chickadee-tech/uOSD/pcb/Bill_Of_Materials.csv

part name | symbol | size (imp) | max current | unit price | units per build | units in stock | order total | Manufacturer ID | source url | datasheet | datasheet2
80 pin header | PORT_IN1 |  |  | $1.35 | 1 | 1 | $1.35 | DF40C-80DP-0.4V(51) | http://www.digikey.com/product-detail/en/DF40C-80DP-0.4V(51)/H11632CT-ND/1969511 | N | http://www.hirose.co.jp/cataloge_hp/ed_DF40_20140305.pdf |  | Total Base Cost | $8.49
80 pin receptacle (4.0mm) | PORT_OUT1 |  |  | $2.67 | 1 | 8 | $2.67 | DF40HC(4.0)-80DS-0.4V(51) | http://www.digikey.com/product-detail/en/DF40HC(4.0)-80DS-0.4V(51)/H11919CT-ND/2530301 | N |  | price ranges 1.40 - 2.50
AND/OR gate | PORT_ANDOR1 |  |  | $0.25 | 1 | 2 | $0.25 | SN74LVC1G0832DCKR | http://www.digikey.com/product-detail/en/SN74LVC1G0832DCKR/296-18754-1-ND/863884 |  | http://www.ti.com/lit/ds/symlink/sn74lvc1g0832.pdf
multifunction gate | PORT_XOR1, PORT_INV1 |  |  | $0.14 | 2 | 6 | $0.28 | SN74LVC1G58DCKR | http://www.digikey.com/product-detail/en/SN74LVC1G58DCKR/296-15577-1-ND/571153 |  | http://www.ti.com/lit/ds/symlink/sn74lvc1g58.pdf
64kbit eeprom | PORT_IC1 | udfn |  | $0.61 | 1 | 2 | $0.61 | AT24CS64-MAHM-T | http://www.digikey.com/product-detail/en/AT24CS64-MAHM-T/AT24CS64-MAHM-TCT-ND/4292118 | N | http://www.atmel.com/images/atmel-8870-seeprom-at24cs64-datasheet.pdf
R 10k | PORT_R1 | 603 |  | $0.01 | 1 | 979 | $0.01 | RC0603FR-0710KL | http://www.digikey.com/product-detail/en/RC0603FR-0710KL/311-10.0KHRCT-ND/729827 | MF-RES-0603-10K | http://www.yageo.com/NewPortal/yageodocoutput?fileName=/pdf/R-Chip/PYu-RC_Group_51_RoHS_L_3.pdf
C 0.1uF | PORT_C1 | 603 |  | $0.02 | 1 | 400 | $0.02 | C0603C104K4RACTU | http://www.digikey.com/product-detail/en/C0603C104K4RACTU/399-1096-1-ND/411371 | MF-CAP-0603-0.1uF | http://www.kemet.com/docfinder?Partnumber=C0603C104K4RACTU
C 10uF X5R | C1 | 1206 |  | $0.24 | 1 | 80 | $0.24 | C3216X5R1C106M160AA | http://www.digikey.com/product-detail/en/C3216X5R1C106M160AA/445-1426-1-ND/569092 | MF-CAP-1206-10uF | http://product.tdk.com/en/catalog/datasheets/mlcc_commercial_general_en.pdf
C 0.1uF | C2, C3 | 603 |  | $0.02 | 2 | 400 | $0.04 | C0603C104K4RACTU | http://www.digikey.com/product-detail/en/C0603C104K4RACTU/399-1096-1-ND/411371 | MF-CAP-0603-0.1uF | http://www.kemet.com/docfinder?Partnumber=C0603C104K4RACTU
red led | D1 |  |  | $0.19 | 1 | 71 | $0.19 | LTST-C190KRKT | http://www.digikey.com/product-detail/en/LTST-C190KRKT/160-1436-1-ND/386816 | MF-LED-0603-RED | http://optoelectronics.liteon.com/upload/download/DS-22-99-0151/S_110_LTST-C190KRKT.pdf
Schottky Diode (Logic Level) | D2 | SC-79, SOD-523F | 30mA | $0.19 | 1 | 4 | $0.19 | RB751S40 | http://www.digikey.com/product-detail/en/RB751S40/RB751S40CT-ND/1969050 | N | https://www.fairchildsemi.com/datasheets/RB/RB751S40.pdf
1x6 right angle tin | Off Board |  |  | $0.33 | 1 | 0 | $0.33 | 22-28-8060 |  | N
1x6 straight | Off Board |  |  | $0.30 | 1 | 3 | $0.30 | 22-28-4060 |  | N
R 1k | R1 | 603 |  | $0.01 | 1 | 993 | $0.01 | RC0603FR-071KL | http://www.digikey.com/product-detail/en/RC0603FR-071KL/311-1.00KHRCT-ND/729790 | MF-RES-0603-1K | http://www.yageo.com/NewPortal/yageodocoutput?fileName=/pdf/R-Chip/PYu-RC_Group_51_RoHS_L_3.pdf
R 10k | R2, R3, R4 | 603 |  | $0.01 | 3 | 979 | $0.03 | RC0603FR-0710KL | http://www.digikey.com/product-detail/en/RC0603FR-0710KL/311-10.0KHRCT-ND/729827 | MF-RES-0603-10K | http://www.yageo.com/NewPortal/yageodocoutput?fileName=/pdf/R-Chip/PYu-RC_Group_51_RoHS_L_3.pdf
R 470 | R5 | 603 |  | $0.00 | 1 | 498 | $0.00 | RC0603JR-07470RL | http://www.digikey.com/product-detail/en/yageo/RC0603JR-07470RL/311-470GRCT-ND/729738 | MF-RES-0603-470 | http://www.yageo.com/NewPortal/yageodocoutput?fileName=/pdf/R-Chip/PYu-RC_Group_51_RoHS_L_3.pdf
Auto Power Switch | U1 | 8-TSSOP | 900mA | $1.84 | 1 | 1 | $1.84 | TPS2112APWR | http://www.ti.com/lit/ds/symlink/tps2112a.pdf | N | http://www.ti.com/lit/ds/symlink/tps2112a.pdf
4mm Spacer | Off Board |  |  | $0.04 | 1 | 78 | $0.04 | 908-4MM | http://www.mouser.com/ProductDetail/Bivar/908-4MM/ | N | http://www.bivar.com/Portals/0/Products/d.ashx?f=/Portals/0/products/9XX-XXX.pdf
n-channel mosfet | Q1 | TO-236-3, SC-59, SOT-23-3 | 220mA continuous | $0.09 | 1 | 59 | $0.09 | BSS138 | http://www.digikey.com/product-detail/en/BSS138/BSS138CT-ND/244294 | MF-DSC-SOT233-BSS138 | https://www.fairchildsemi.com/datasheets/BS/BSS138.pdf
