chickadee-tech/uOSD/pcb/uMinimOSD.kicad_pcb

## KiCad design pcb/uMinimOSD.kicad_pcb (2016-07-07)

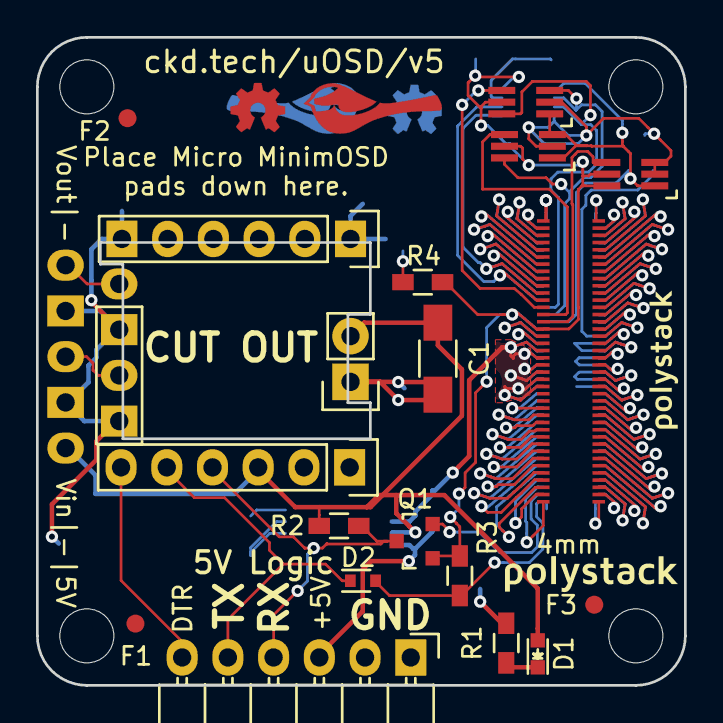
[picture p1: board uMinimOSD.kicad_pcb from above]

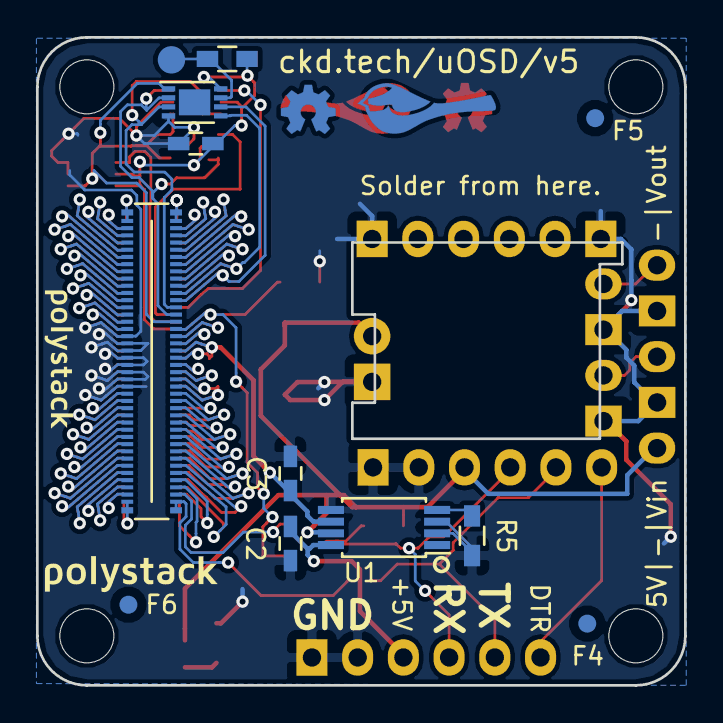
[picture p2: board uMinimOSD.kicad_pcb from below]

Board: 2 copper layers, 36.0 x 36.0 mm, 37 parts (14 on the bottom side), 81 nets.

Parts:
C1: 10uF; C_1206_HandSoldering
C2, C3: 0.1uF; C_0603_HandSoldering
D1: Red; LED-0603
D2: RB751S40; SOD-523
F1, F2, F3, F4, F5, F6: 1mm; Fiducial
P1: CONN_01X05; Pin_Header_Straight_1x05
P2: CONN_01X04; Pin_Header_Straight_1x04
P3, P4: CONN_01X06; Pin_Header_Straight_1x06
P5: CONN_01X02; Pin_Header_Straight_1x02
P6: CONN_01X06; Pin_Header_Angled_1x06
PORT_ANDOR1: SN74LVC1G0832; SC-70-6_Handsoldering
PORT_C1: 0.1uF; C_0603_HandSoldering
PORT_IC1: AT24CS02-MAHM; DFN-8-1EP_3x2mm_Pitch0.5mm
PORT_IN1: CKD_SANDWICH; DF40-80pin-Header
PORT_INV1: SN74LVC1G58; SC-70-6_Handsoldering
PORT_OUT1: CKD_SANDWICH; DF40-3-4mm-80pin-Receptacle
PORT_P1: CONN_01X01; Measurement_Point_Round-SMD-Pad_Small
PORT_R1: 10k; R_0603_HandSoldering
PORT_XOR1: SN74LVC1G58; SC-70-6_Handsoldering
Q1: Q_NMOS_GSD; SOT-23
R1: 1k; R_0603_HandSoldering
R2, R3, R4: 10k; R_0603_HandSoldering
R5: 470; R_0603_HandSoldering
U1: TPS2112; TSSOP-8_4.4x3mm_Pitch0.65mm
svg2mod, svg2mod#2: G***; polystack-bold-0.5
svg2mod#3, svg2mod#4: G***; polystack-bold-0.4

Connections:
+3V3: PORT_ANDOR1.5, PORT_C1.1, PORT_IC1.8, PORT_IN1.16, PORT_INV1.5, PORT_INV1.6, PORT_OUT1.16, PORT_R1.2, PORT_XOR1.5, Q1.1, R3.1, R4.1
+5V: C1.1, D1.2, P1.1, P3.3, P5.2, R2.1, U1.7
/DTR: P3.6, P6.6
/ExpansionPort/3V3_0.3A_E: PORT_IN1.17, PORT_OUT1.17
/ExpansionPort/+BATT: PORT_IN1.18, PORT_OUT1.18
/ExpansionPort/ADC1: PORT_IN1.49, PORT_OUT1.49
/ExpansionPort/ADC2: PORT_IN1.50, PORT_OUT1.50
/ExpansionPort/BOOT: PORT_IN1.65, PORT_OUT1.65
/ExpansionPort/CAN_HI: PORT_IN1.67, PORT_OUT1.67
/ExpansionPort/CAN_LO: PORT_IN1.68, PORT_OUT1.68
/ExpansionPort/FS_5V: C3.1, PORT_IN1.19, PORT_IN1.20, PORT_IN1.21, PORT_IN1.22, PORT_IN1.23, PORT_IN1.24, PORT_OUT1.19, PORT_OUT1.20, PORT_OUT1.21, PORT_OUT1.22, PORT_OUT1.23, PORT_OUT1.24, U1.6
/ExpansionPort/GPIO1: PORT_IN1.5, PORT_OUT1.5
/ExpansionPort/GPIO2: PORT_IN1.6, PORT_OUT1.6
/ExpansionPort/GPIO3: PORT_IN1.7, PORT_OUT1.7
/ExpansionPort/GPIO4: PORT_IN1.8, PORT_OUT1.8
/ExpansionPort/GPIO5: PORT_IN1.9, PORT_OUT1.9
/ExpansionPort/GPIO6: PORT_IN1.10, PORT_OUT1.10
/ExpansionPort/HEIGHT_1: PORT_ANDOR1.1, PORT_IC1.1, PORT_IN1.15, PORT_INV1.1, PORT_XOR1.1, PORT_XOR1.3
/ExpansionPort/HEIGHT_2: PORT_ANDOR1.3, PORT_IC1.2, PORT_IN1.14, PORT_XOR1.6
/ExpansionPort/HEIGHT_4: PORT_ANDOR1.6, PORT_IC1.3, PORT_IN1.13
/ExpansionPort/NEW_HEIGHT_1: PORT_INV1.4, PORT_OUT1.15
/ExpansionPort/NEW_HEIGHT_2: PORT_OUT1.14, PORT_XOR1.4
/ExpansionPort/NEW_HEIGHT_4: PORT_ANDOR1.4, PORT_OUT1.13
/ExpansionPort/RESET: PORT_IN1.66, PORT_OUT1.66
/ExpansionPort/SDMMC1_CK: PORT_IN1.55, PORT_OUT1.55
/ExpansionPort/SDMMC1_CMD: PORT_IN1.56, PORT_OUT1.56
/ExpansionPort/SDMMC1_D0: PORT_IN1.51, PORT_OUT1.51
/ExpansionPort/SDMMC1_D1: PORT_IN1.52, PORT_OUT1.52
/ExpansionPort/SDMMC1_D2: PORT_IN1.53, PORT_OUT1.53
/ExpansionPort/SDMMC1_D3: PORT_IN1.54, PORT_OUT1.54
/ExpansionPort/SPI1_MISO: PORT_IN1.79, PORT_OUT1.79
/ExpansionPort/SPI1_MOSI: PORT_IN1.80, PORT_OUT1.80
/ExpansionPort/SPI1_NSS: PORT_IN1.77, PORT_OUT1.77
/ExpansionPort/SPI1_SCK: PORT_IN1.78, PORT_OUT1.78
/ExpansionPort/SPI2_MISO: PORT_IN1.75, PORT_OUT1.75
/ExpansionPort/SPI2_MOSI: PORT_IN1.76, PORT_OUT1.76
/ExpansionPort/SPI2_NSS: PORT_IN1.73, PORT_OUT1.73
/ExpansionPort/SPI2_SCK: PORT_IN1.74, PORT_OUT1.74
/ExpansionPort/SPI3_MISO: PORT_IN1.71, PORT_OUT1.71
/ExpansionPort/SPI3_MOSI: PORT_IN1.72, PORT_OUT1.72
/ExpansionPort/SPI3_NSS: PORT_IN1.69, PORT_OUT1.69
/ExpansionPort/SPI3_SCK: PORT_IN1.70, PORT_OUT1.70
/ExpansionPort/TIM1: PORT_IN1.1, PORT_OUT1.1
/ExpansionPort/TIM2: PORT_IN1.2, PORT_OUT1.2
/ExpansionPort/TIM3: PORT_IN1.3, PORT_OUT1.3
/ExpansionPort/TIM4: PORT_IN1.4, PORT_OUT1.4
/ExpansionPort/TIMG1_CH1: PORT_IN1.41, PORT_OUT1.41
/ExpansionPort/TIMG1_CH2: PORT_IN1.42, PORT_OUT1.42
/ExpansionPort/TIMG1_CH3: PORT_IN1.43, PORT_OUT1.43
/ExpansionPort/TIMG1_CH4: PORT_IN1.44, PORT_OUT1.44
/ExpansionPort/TIMG2_CH1: PORT_IN1.45, PORT_OUT1.45
/ExpansionPort/TIMG2_CH2: PORT_IN1.46, PORT_OUT1.46
/ExpansionPort/TIMG2_CH3: PORT_IN1.47, PORT_OUT1.47
/ExpansionPort/TIMG2_CH4: PORT_IN1.48, PORT_OUT1.48
/ExpansionPort/UART1_RX: D2.2, PORT_IN1.40, R3.2
/ExpansionPort/UART1_TX: PORT_IN1.39, Q1.2
/ExpansionPort/UART2_RX: PORT_IN1.38, PORT_OUT1.40
/ExpansionPort/UART2_TX: PORT_IN1.37, PORT_OUT1.39
/ExpansionPort/UART3_RX: PORT_IN1.36, PORT_OUT1.38
/ExpansionPort/UART3_TX: PORT_IN1.35, PORT_OUT1.37
/ExpansionPort/UART4_RX: PORT_IN1.34, PORT_OUT1.36
/ExpansionPort/UART4_TX: PORT_IN1.33, PORT_OUT1.35
/ExpansionPort/UART5_RX: PORT_IN1.32, PORT_OUT1.34
/ExpansionPort/UART5_TX: PORT_IN1.31, PORT_OUT1.33
/ExpansionPort/UART6_RX: PORT_IN1.30, PORT_OUT1.32
/ExpansionPort/UART6_TX: PORT_IN1.29, PORT_OUT1.31
/ExpansionPort/UART7_RX: PORT_IN1.28, PORT_OUT1.30
/ExpansionPort/UART7_TX: PORT_IN1.27, PORT_OUT1.29
/ExpansionPort/UART8_RX: PORT_IN1.26, PORT_OUT1.28
/ExpansionPort/UART8_TX: PORT_IN1.25, PORT_OUT1.27
/ExpansionPort/i2c_SCL: PORT_IC1.6, PORT_IN1.12, PORT_OUT1.12
/ExpansionPort/i2c_SDA: PORT_IC1.5, PORT_IN1.11, PORT_OUT1.11
/FTDI_5V: C2.1, P6.3, U1.8
/RX: D2.1, P3.5, P6.5
/TX: P3.4, P6.4, Q1.3, R2.2
/Vin: P1.3, P2.3
/Vout: P1.5, P2.1
GNDPWR: C1.2, C2.2, C3.2, P1.2, P1.4, P2.2, P2.4, P3.1, P3.2, P4.1, P4.6, P5.1, P6.1, P6.2, PORT_ANDOR1.2, PORT_C1.2, PORT_IC1.4, PORT_IN1.57, PORT_IN1.58, PORT_IN1.59, PORT_IN1.60, PORT_IN1.61, PORT_IN1.62, PORT_IN1.63, PORT_IN1.64, PORT_INV1.2, PORT_INV1.3, PORT_OUT1.57, PORT_OUT1.58, PORT_OUT1.59, PORT_OUT1.60, PORT_OUT1.61, PORT_OUT1.62, PORT_OUT1.63, PORT_OUT1.64, PORT_XOR1.2, R1.2, R4.2, R5.2, U1.2, U1.3, U1.5
unnamed: D1.1, R1.1
unnamed: PORT_IC1.7, PORT_P1.1, PORT_R1.1
unnamed: R5.1, U1.4
