chickadee-tech/uOSD/(commit log)

2016-01-07 v1 of a Micro Minim OSD cradle.
    [ExpansionPort.sch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]
2016-02-06 v2 of uMinimOSD which corrects RX and TX and also makes it available in ftdi form.
    [Bill_Of_Materials.csv, ExpansionPort.sch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]
2016-04-07 Correct pinout of power or IC.
    [Bill_Of_Materials.csv, ExpansionPort.sch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]
2016-04-13 Rebrand everything to Polystack and increment versions.
    [uMinimOSD.kicad_pcb]
2016-04-16 Final gerbers for test manufacturing run.
    [uMinimOSD-B.Cu.gbl, uMinimOSD-B.Mask.gbs, uMinimOSD-B.Paste.gbp, uMinimOSD-B.SilkS.gbo, uMinimOSD-Edge.Cuts.gm1, uMinimOSD-F.Cu.gtl, uMinimOSD-F.Mask.gts, uMinimOSD-F.Paste.gtp]
2016-06-07 Remove extra chickadee logo, pdate polystack logo to bold variant, connect i2c lines to eeprom and bump version number.
    [uMinimOSD-B.Cu.gbl, uMinimOSD-B.Mask.gbs, uMinimOSD-B.Paste.gbp, uMinimOSD-B.SilkS.gbo, uMinimOSD-Edge.Cuts.gm1, uMinimOSD-F.Cu.gtl, uMinimOSD-F.Mask.gts, uMinimOSD-F.Paste.gtp]
2016-07-07 Add license information to many files. PCB design files are CC-BY and code is MIT license.
    [ExpansionPort.sch, uMinimOSD.kicad_pcb, uMinimOSD.sch]
2016-07-07 Convert to relative component and footprint paths.
    [ExpansionPort.sch, uMinimOSD.sch]
